stsb11/9-SC-LED/pages/img/lamps.jpg

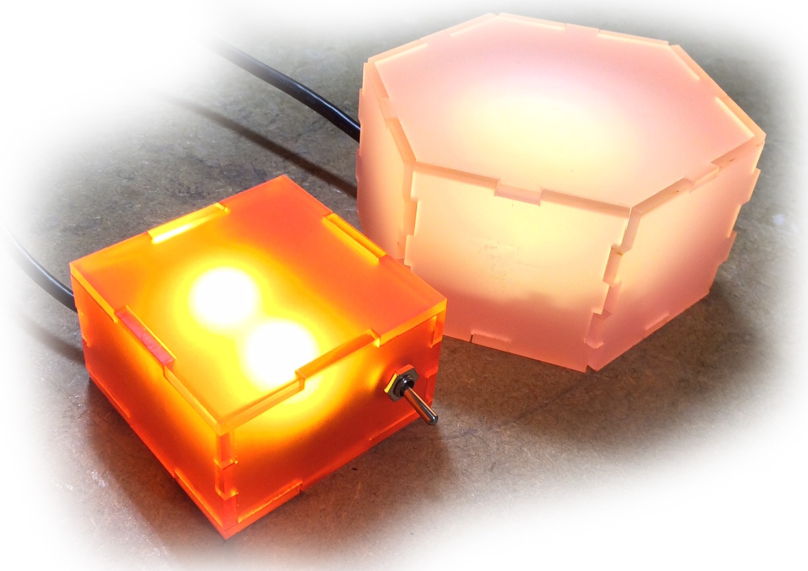
pages/img/lamps.jpg
