stsb11/9-SC-LED/pages/img/sboard.jpg

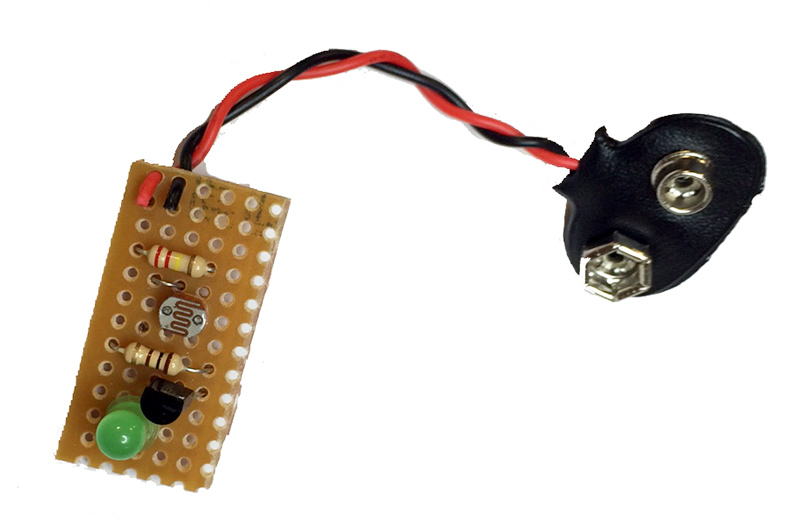
pages/img/sboard.jpg
