stsb11/9-SC-LED/index.org

#+STARTUP:indent
#+HTML_HEAD: <link rel="stylesheet" type="text/css" href="pages/css/styles.css"/>
#+HTML_HEAD_EXTRA: <link href='http://fonts.googleapis.com/css?family=Ubuntu+Mono|Ubuntu' rel='stylesheet' type='text/css'>
#+OPTIONS: f:nil author:nil num:nil creator:nil timestamp:nil  toc:nil
#+TITLE: Design Project
#+AUTHOR: Stephen Brown

#+BEGIN_HTML
<div class="github-fork-ribbon-wrapper left">
    <div class="github-fork-ribbon">
        <a href="https://github.com/stsb11/9-SC-LED">Fork me on GitHub</a>
    </div>
</div>
#+END_HTML
* [[file:pages/1_Lesson.html][Task 1 - Initial design]]
:PROPERTIES:
:HTML_CONTAINER_CLASS: link-heading
:END:
* [[file:pages/2_Lesson.html][Task 2 - 3D Design]]
:PROPERTIES:
:HTML_CONTAINER_CLASS: link-heading
:END:      
* [[file:pages/3_Lesson.html][Task 3 - PCB design]] 
:PROPERTIES:
:HTML_CONTAINER_CLASS: link-heading
:END:
* [[file:pages/4_Lesson.html][Task 4 - PCB build]]
:PROPERTIES:
:HTML_CONTAINER_CLASS: link-heading
:END:      

* [[file:pages/5_Lesson.html][Task 5 - Housing manufacture]]
:PROPERTIES:
:HTML_CONTAINER_CLASS: link-heading
:END:      

* [[file:pages/6_Lesson.html][Task 6 - Assembly]]
:PROPERTIES:
:HTML_CONTAINER_CLASS: link-heading
:END:      

* [[file:pages/7_Homework.html][Homework Tasks]]
:PROPERTIES:
:HTML_CONTAINER_CLASS: link-heading
:END:
