stsb11/9-SC-LED/source/2_Lesson.org

#+STARTUP:indent
#+HTML_HEAD: <link rel="stylesheet" type="text/css" href="css/styles.css"/>
#+HTML_HEAD_EXTRA: <link href='http://fonts.googleapis.com/css?family=Ubuntu+Mono|Ubuntu' rel='stylesheet' type='text/css'>
#+HTML_HEAD_EXTRA: <script src="http://ajax.googleapis.com/ajax/libs/jquery/1.9.1/jquery.min.js" type="text/javascript"></script>
#+HTML_HEAD_EXTRA: <script src="js/navbar.js" type="text/javascript"></script>
#+OPTIONS: f:nil author:nil num:1 creator:nil timestamp:nil toc:nil html-style:nil

#+TITLE: Design Project
#+AUTHOR: Stephen Brown

#+BEGIN_HTML
  <div class="github-fork-ribbon-wrapper left">
    <div class="github-fork-ribbon">
      <a href="https://github.com/stsb11/9-SC-LED">Fork me on GitHub</a>
    </div>
  </div>
<div id="stickyribbon">
    <ul>
      <li><a href="1_Lesson.html">Week 1</a></li>
      <li><a href="2_Lesson.html">Week 2</a></li>
      <li><a href="3_Lesson.html">Week 3</a></li>
      <li><a href="4_Lesson.html">Week 4</a></li>
      <li><a href="5_Lesson.html">Week 5</a></li>
      <li><a href="6_Lesson.html">Week 6</a></li>
      <li><a href="assessment.html">Assessment</a></li>

    </ul>
  </div>
#+END_HTML
* COMMENT Use as a template
:PROPERTIES:
:HTML_CONTAINER_CLASS: activity
:END:
** Learn It
:PROPERTIES:
:HTML_CONTAINER_CLASS: learn
:END:

** Research It
:PROPERTIES:
:HTML_CONTAINER_CLASS: research
:END:

** Design It
:PROPERTIES:
:HTML_CONTAINER_CLASS: design
:END:

** Build It
:PROPERTIES:
:HTML_CONTAINER_CLASS: build
:END:

** Test It
:PROPERTIES:
:HTML_CONTAINER_CLASS: test
:END:

** Run It
:PROPERTIES:
:HTML_CONTAINER_CLASS: run
:END:

** Document It
:PROPERTIES:
:HTML_CONTAINER_CLASS: document
:END:

** Code It
:PROPERTIES:
:HTML_CONTAINER_CLASS: code
:END:

** Program It
:PROPERTIES:
:HTML_CONTAINER_CLASS: program
:END:

** Try It
:PROPERTIES:
:HTML_CONTAINER_CLASS: try
:END:

** Badge It
:PROPERTIES:
:HTML_CONTAINER_CLASS: badge
:END:

** Save It
:PROPERTIES:
:HTML_CONTAINER_CLASS: save
:END:

* 3D CAD
:PROPERTIES:
:HTML_CONTAINER_CLASS: activity
:END:

** Learn It
:PROPERTIES:
:HTML_CONTAINER_CLASS: learn
:END:
- You'll need to design the parts of your housing in SolidWorks.
- If you're not a confident SolidWorks user, these videos will walk you through building a quick letter rack using the basic design tools. 
#+BEGIN_HTML
<iframe width="560" height="315" src="https://www.youtube.com/embed/pw2K8tAtLHs" frameborder="0" allowfullscreen></iframe>
<br><br>
<iframe width="560" height="315" src="https://www.youtube.com/embed/YlpAn7Rvolc?list=PLjwXcI6i_ZJHFMidPPHUNImmMUon14GYg" frameborder="0" allowfullscreen></iframe>
<br><br>
<iframe width="560" height="315" src="https://www.youtube.com/embed/HIr6I7O42rk?list=PLjwXcI6i_ZJHFMidPPHUNImmMUon14GYg" frameborder="0" allowfullscreen></iframe>
#+END_HTML
- If you're feeling a little more ambitious, this tutorial teaches you a few more techniques that will let you build a 3D-printable model.
- *NOTE:* 3D printing makes lovely models, but the plastic isn't see-though. 
- *NOTE:* 3D-printing is a slow process. Manufacturing the TARDIS from the video tutorial below took around 10 hours. Bear this in mind if you want to 3D print your light, and aim to finish your model early to ensure you get time on one of the printers. 
#+BEGIN_HTML
<iframe width="560" height="315" src="https://www.youtube.com/embed/ifjnrfjPCjQ" frameborder="0" allowfullscreen></iframe>
#+END_HTML
** Design It
:PROPERTIES:
:HTML_CONTAINER_CLASS: design
:END:
- Design the housing for your light.
- *The PCB:* Although you've not designed it yet, experience tells us that your circuit will be around 3mm X 25mm X 20mm (HxWxD). It's probably a good idea to design a small rectangular part this size, so that you can check later on that it'll fit inside your model. Don't worry about including holes to mount it yet (you can see some in my example at the top of the page) - we'll add these once you've designed your board.
- *The Switch:* You'll want to use a small toggle switch to turn your light on and off. One of your side walls will need a hole with a 3mm radius (6mm diameter) in it for the switch to stick through. SolidWorks is a very popular program around the World, and many other engineers and designers have created detailed parts which they have shared with others. As it happens, you can download the switch you'll be using [[./T-Switch.SLDASM][here]] and insert it into your assembly. *TIP:* Once you insert the switch, make sure there will be some space for the wires to to PCB to go. You don't need a lot, but you don't want the back of the switch touching the PCB, for example.
- *Power wires:* Are you going to store your battery inside the housing (more portable), or outside (for easy battery changing)? If you want it external, you'll want to include a 1.5mm radius hole somewhere on one of the side walls.
#+BEGIN_HTML
<iframe width="560" height="315" src="https://www.youtube.com/embed/IGWfrjBgPzs" frameborder="0" allowfullscreen></iframe>
<iframe width="560" height="315" src="https://www.youtube.com/embed/KpscA_nC9GA" frameborder="0" allowfullscreen></iframe>
#+END_HTML

** Badge It
:PROPERTIES:
:HTML_CONTAINER_CLASS: badge
:END:
- /Silver:/ Design and mate together at least two fully defined parts in an assembly.
- /Gold:/ Include finger points in your assembled model parts.
- /Platinum:/ Create a fully defined complete design.
