stsb11/9-SC-LED/source/6_Lesson.org

#+STARTUP:indent
#+HTML_HEAD: <link rel="stylesheet" type="text/css" href="css/styles.css"/>
#+HTML_HEAD_EXTRA: <link href='http://fonts.googleapis.com/css?family=Ubuntu+Mono|Ubuntu' rel='stylesheet' type='text/css'>
#+HTML_HEAD_EXTRA: <script src="http://ajax.googleapis.com/ajax/libs/jquery/1.9.1/jquery.min.js" type="text/javascript"></script>
#+HTML_HEAD_EXTRA: <script src="js/navbar.js" type="text/javascript"></script>
#+OPTIONS: f:nil author:nil num:1 creator:nil timestamp:nil toc:nil html-style:nil

#+TITLE: Design Project
#+AUTHOR: Stephen Brown

#+BEGIN_HTML
  <div class="github-fork-ribbon-wrapper left">
    <div class="github-fork-ribbon">
      <a href="https://github.com/stsb11/9-SC-LED">Fork me on GitHub</a>
    </div>
  </div>
<div id="stickyribbon">
    <ul>
      <li><a href="1_Lesson.html">Week 1</a></li>
      <li><a href="2_Lesson.html">Week 2</a></li>
      <li><a href="3_Lesson.html">Week 3</a></li>
      <li><a href="4_Lesson.html">Week 4</a></li>
      <li><a href="5_Lesson.html">Week 5</a></li>
      <li><a href="6_Lesson.html">Week 6</a></li>
      <li><a href="assessment.html">Assessment</a></li>

    </ul>
  </div>
#+END_HTML
* COMMENT Use as a template
:PROPERTIES:
:HTML_CONTAINER_CLASS: activity
:END:
** Learn It
:PROPERTIES:
:HTML_CONTAINER_CLASS: learn
:END:

** Research It
:PROPERTIES:
:HTML_CONTAINER_CLASS: research
:END:

** Design It
:PROPERTIES:
:HTML_CONTAINER_CLASS: design
:END:

** Build It
:PROPERTIES:
:HTML_CONTAINER_CLASS: build
:END:

** Test It
:PROPERTIES:
:HTML_CONTAINER_CLASS: test
:END:

** Run It
:PROPERTIES:
:HTML_CONTAINER_CLASS: run
:END:

** Document It
:PROPERTIES:
:HTML_CONTAINER_CLASS: document
:END:

** Code It
:PROPERTIES:
:HTML_CONTAINER_CLASS: code
:END:

** Program It
:PROPERTIES:
:HTML_CONTAINER_CLASS: program
:END:

** Try It
:PROPERTIES:
:HTML_CONTAINER_CLASS: try
:END:

** Badge It
:PROPERTIES:
:HTML_CONTAINER_CLASS: badge
:END:

** Save It
:PROPERTIES:
:HTML_CONTAINER_CLASS: save
:END:

* Assembly
:PROPERTIES:
:HTML_CONTAINER_CLASS: activity
:END:
** Switch it
:PROPERTIES:
:HTML_CONTAINER_CLASS: build
:END:
- With all your component parts, you can now assemble your finished product. Because of all your hard work, this will be a quick process. 

- The power switch needs to be wired up as per the diagram above. Cut the red wire on the PP3 battery cable about half-way along, and wire strip the two ends of the cut.
- You can then remove the nut from the front of the switch, pass it through the 6mm hole you've made and put the nut back on to hole the switch in place. Tighten it *gently* with pliers while holding the back of the switch.
- Solder one to the middle lug of the switch (there's a little hole in it to make this easier)
- Solder the other end to either of the two remaining lugs. 

** Protect It
:PROPERTIES:
:HTML_CONTAINER_CLASS: build
:END:
- Diodes only allow current to flow in /One Direction/. They also use up 0.7V of the available voltage in our circuit. This isn't much, but will reduce the amount of voltage going into your circuit and prevent it from getting hot.
- Cut your black PP3 wire, and solder a rectifier diode in-line, with the gray band facing towards the PP3 battery snap. You can see mine resting on top of the switch in the picture above. 
- Use spacers (cut them in half with side cutters to reduce their height) on top of the machine screws, then finally place your PCB on top and secure it into place *gently* with a pair of M3 nuts. 
- Use PVA glue to stick MDF parts of your housing together.
- Don't stick the lid down if you're going for an internal battery, otherwise you'll never be able to change it! 
- PVA glue takes 24 hours to form a full-strength bond, but the body of your lamp should be fine to handle after about an hour. 
** Mount It
:PROPERTIES:
:HTML_CONTAINER_CLASS: build
:END:
- To avoid scratching your furniture at home, use the countersink tool on the bottom of your base before putting M3x20 countersunk machine screws in.

- Use spacers (cut them in half with side cutters to reduce their height) on top of the machine screws, then finally place your PCB on top and secure it into place *gently* with a pair of M3 nuts. 
- Use PVA glue to stick MDF parts of your housing together.
- Don't stick the lid down if you're going for an internal battery, otherwise you'll never be able to change it! 
- PVA glue takes 24 hours to form a full-strength bond, but the body of your lamp should be fine to handle after about an hour. 
** Badge It
:PROPERTIES:
:HTML_CONTAINER_CLASS: badge
:END:
- Take a photo of your finished product, and upload it.
- /Silver:/ Assemble some aspects of product, but not finish.
- /Gold:/ Produce a working LED lamp.
- /Platinum:/ Free from excess glue, neat countersinks, good quality finish.
