stsb11/9-SC-LED/source/3_Lesson.org

#+STARTUP:indent
#+HTML_HEAD: <link rel="stylesheet" type="text/css" href="css/styles.css"/>
#+HTML_HEAD_EXTRA: <link href='http://fonts.googleapis.com/css?family=Ubuntu+Mono|Ubuntu' rel='stylesheet' type='text/css'>
#+HTML_HEAD_EXTRA: <script src="http://ajax.googleapis.com/ajax/libs/jquery/1.9.1/jquery.min.js" type="text/javascript"></script>
#+HTML_HEAD_EXTRA: <script src="js/navbar.js" type="text/javascript"></script>
#+OPTIONS: f:nil author:nil num:1 creator:nil timestamp:nil toc:nil html-style:nil

#+TITLE: Design Project
#+AUTHOR: Stephen Brown

#+BEGIN_HTML
  <div class="github-fork-ribbon-wrapper left">
    <div class="github-fork-ribbon">
      <a href="https://github.com/stsb11/9-SC-LED">Fork me on GitHub</a>
    </div>
  </div>
<div id="stickyribbon">
    <ul>
      <li><a href="1_Lesson.html">Week 1</a></li>
      <li><a href="2_Lesson.html">Week 2</a></li>
      <li><a href="3_Lesson.html">Week 3</a></li>
      <li><a href="4_Lesson.html">Week 4</a></li>
      <li><a href="5_Lesson.html">Week 5</a></li>
      <li><a href="6_Lesson.html">Week 6</a></li>
      <li><a href="assessment.html">Assessment</a></li>
  
    </ul>
  </div>
#+END_HTML
* COMMENT Use as a template
:PROPERTIES:
:HTML_CONTAINER_CLASS: activity
:END:
** Learn It
:PROPERTIES:
:HTML_CONTAINER_CLASS: learn
:END:

** Research It
:PROPERTIES:
:HTML_CONTAINER_CLASS: research
:END:

** Design It
:PROPERTIES:
:HTML_CONTAINER_CLASS: design
:END:

** Build It
:PROPERTIES:
:HTML_CONTAINER_CLASS: build
:END:

** Test It
:PROPERTIES:
:HTML_CONTAINER_CLASS: test
:END:

** Run It
:PROPERTIES:
:HTML_CONTAINER_CLASS: run
:END:

** Document It
:PROPERTIES:
:HTML_CONTAINER_CLASS: document
:END:

** Code It
:PROPERTIES:
:HTML_CONTAINER_CLASS: code
:END:

** Program It
:PROPERTIES:
:HTML_CONTAINER_CLASS: program
:END:

** Try It
:PROPERTIES:
:HTML_CONTAINER_CLASS: try
:END:

** Badge It
:PROPERTIES:
:HTML_CONTAINER_CLASS: badge
:END:

** Save It
:PROPERTIES:
:HTML_CONTAINER_CLASS: save
:END:

* Circuit Design

:PROPERTIES:
:HTML_CONTAINER_CLASS: activity
:END:
** Learn It
:PROPERTIES:
:HTML_CONTAINER_CLASS: learn
:END:
- The LEDs you're going to use are /very/ bright, 1W models. 
- They'll work with a good-quality 9V battery, but because LEDs have very low internal resistance, if connected directly to the battery they'll draw too much current, quickly overheat and burn out. 
- To reduce the current flow, we'll use some 330 Ohm resistors connected in parallel, which will stop this from happening.
- You're going to need to design a compact Stripboard circuit to take all the component parts. We use DIYlc for stripboard design in School. 
- *Resource:* You can load DIYlc from the open drive in School, in the G:\Systems and Control\Student Home software\DIYlc\ folder. Double-click the 'diylc.exe' file to start.
- *Resource:* At home, DIYlc is available for download [[https://code.google.com/p/diy-layout-creator/][here]].
** Try It
:PROPERTIES:
:HTML_CONTAINER_CLASS: try
:END:
- Download [[./img/start_point.diy][this]] DIYlc file into your H: drive, and use File -> Open in DIYlc to open and view it. You can't just double-click on it.

- This is an example of a stripboard circuit. A few important points have been picked out, which you might want to consider in your design.
  - Strain relief holes only take a few seconds to drill, but will prevent your power wires from breaking off again and again.
  - The legs on the 1W LEDs are a little over 1mm wide. If you don't enlarge the holes on your stripboard a little for them with a drill, they *will* snap off!
  - 3mm holes in the PCB will allow you to poke M3 machine screws through them to secure the lights at the bottom of your housing. 
  - The spot-face cut is to prevent the steel nuts we use from creating a short-circuit and burning out your LEDs. 
- You are seeing the finished circuit from the component side (the side with no copper tracks on it). 
- To make life a little easier, the tracks are also shown (as if you had X-ray vision). 

- Here you can see the path that electrons take through the circuit. Remember that the electrons are unable to jump over the thin gaps between the copper rows of stripboard. 
- Electrons travel in from the red wire, arriving at the top row of the stripboard and attacted towards the negative end of the battery (black wire). 
- As the only route they are presented with is to travel through the + leg of the LED, they pass through here and emerge at the bottom.
- From here (the 4th row from the top), the only route the elctrons can take now is to travel through the parallel resistors, to the bottom row of the piece of stripboard.
- Once at the bottom row, the electrons are able to travel up the black wire to the negative terminal of the battery, completing the circuit. 
** Badge It
:PROPERTIES:
:HTML_CONTAINER_CLASS: badge
:END:

- Using the file provided to you above, modify your design to add another resistor and another LED to create the circuit shown above. 
- *Tip:* When inserted in stripboard, the LEDs occupy 3 columns and 4 rows.
- *Tip:* You'll need to keep two 3mm holes to mount your PCB to the housing. Remember that creating a hole in a row of this size prevents current from travelling past that point in the row.
- You will be awarded a badge for your work :

   - /Silver:/ Additional components added to stripboard design.
   - /Gold:/ Workable final design is 16x7 or under.
   - /Platinum:/ Design is 13x6 or under.
