stsb11/9-SC-LED/pages/img/1w_led.jpg

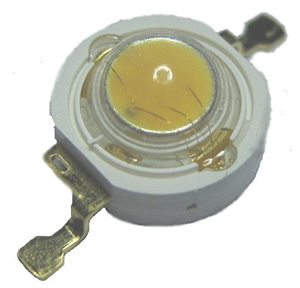
pages/img/1w_led.jpg
