stsb11/9-SC-LED/pages/img/circuit.png

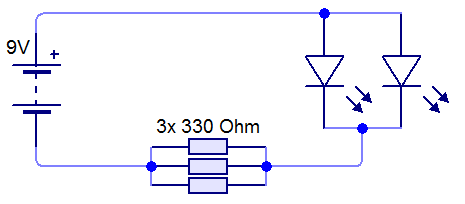
pages/img/circuit.png
