stsb11/9-SC-LED/pages/img/example.png

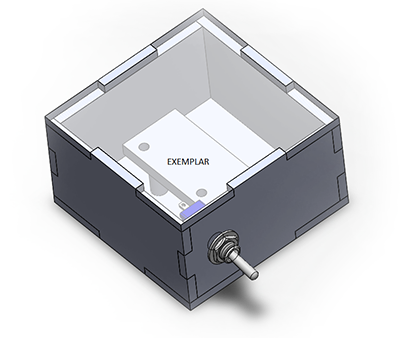
pages/img/example.png
