stsb11/9-SC-LED/pages/img/pwr_switch.png

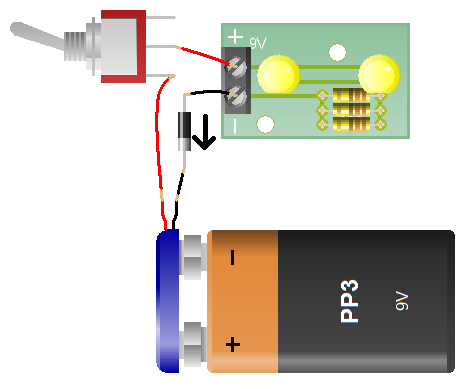
pages/img/pwr_switch.png
