stsb11/9-SC-LED/pages/img/sboard_flow.png

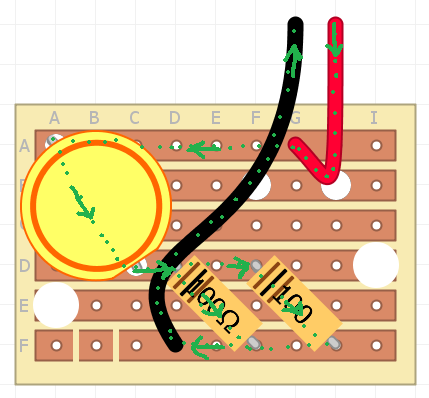
pages/img/sboard_flow.png
