stsb11/9-SC-LED/pages/img/sboard_solution.png

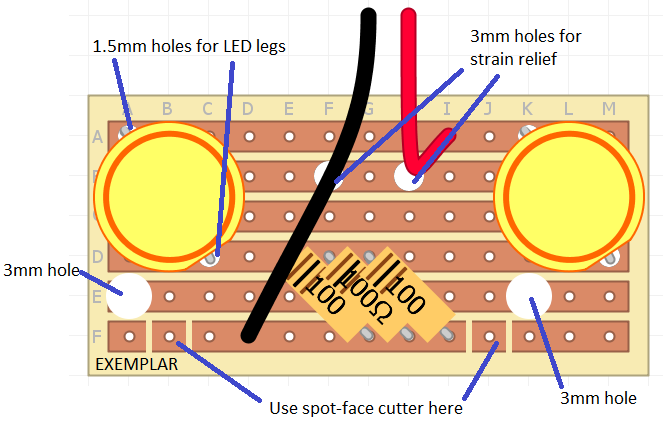
pages/img/sboard_solution.png
