stsb11/9-SC-LED/pages/img/sboard_task.png

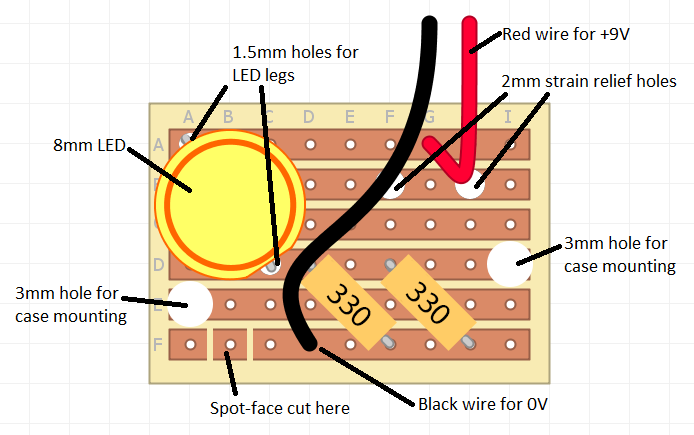
pages/img/sboard_task.png
