stsb11/9-SC-LED/pages/img/spacers.jpg

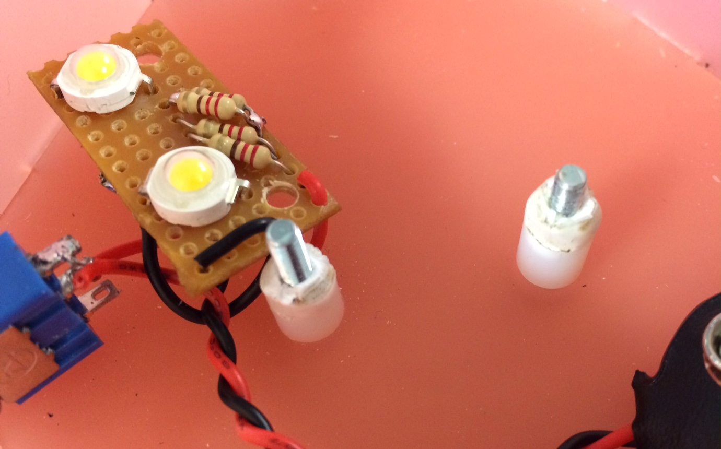
pages/img/spacers.jpg
