stsb11/9-SC-LED/pages/img/switch.jpg

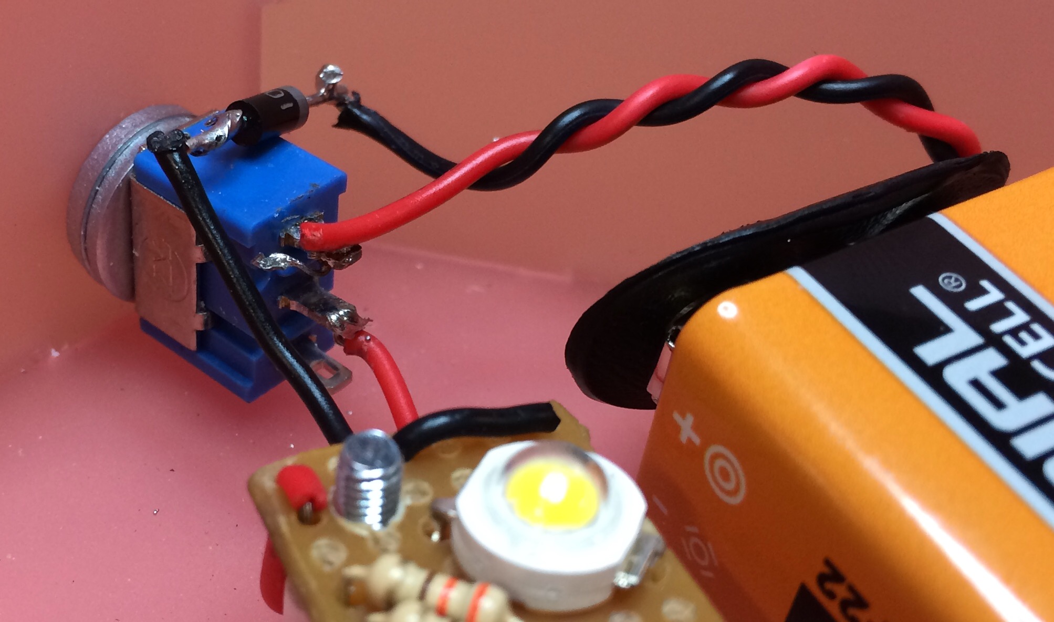
pages/img/switch.jpg
