stsb11/9-SC-LED/pages/T-Switch.SLDASM

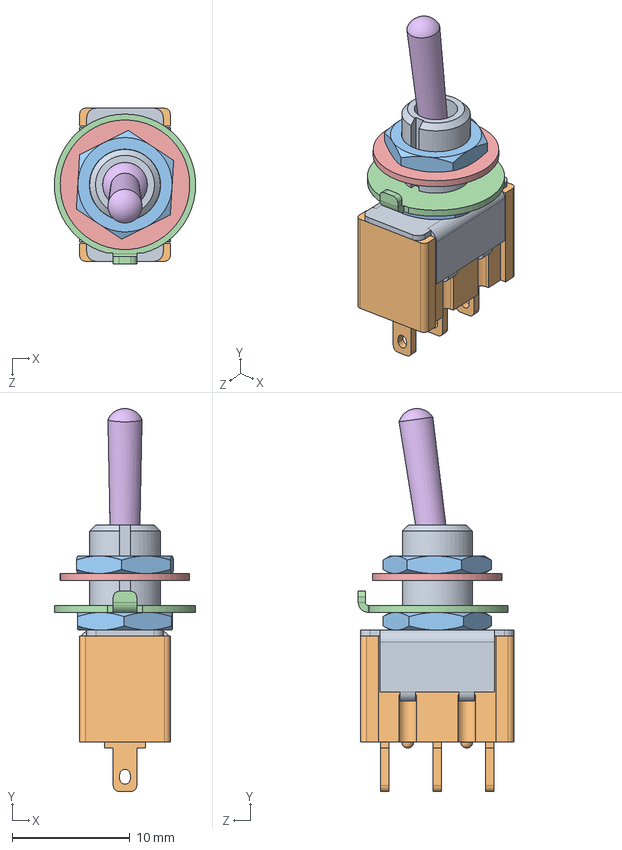
[picture p12: CAD file, 2015-05-20]
pages/T-Switch.SLDASM
12.0 x 32.5 x 13.2 mm
Bush^T-Switch
Body^T-Switch
Hex Nut M6x0.75^T-Switch x 2
Lock Washer^T-Switch
IntTooth Lock Washer M6B^T-Switch
Actuator^T-Switch
